cole-mehring/griffin/Griffin_kicad.kicad_pcb

## KiCad design Griffin_kicad.kicad_pcb (2026-10-20)

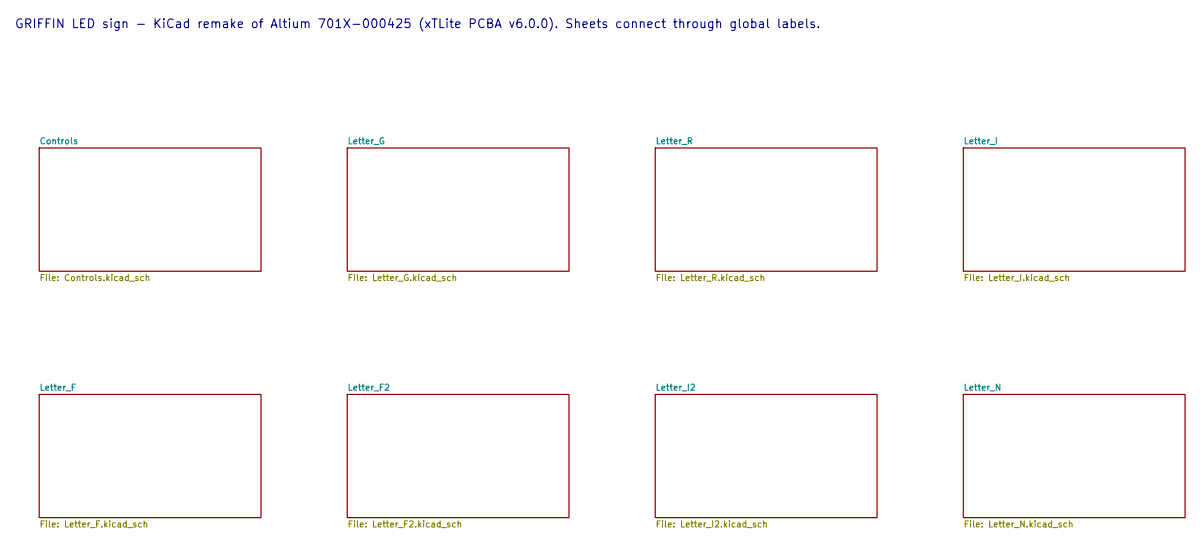
[picture p1: schematic Griffin_kicad.kicad_sch]

Notes on the sheet:
GRIFFIN LED sign - KiCad remake of Altium 701X-000425 (xTLite PCBA v6.0.0). Sheets connect through global labels.

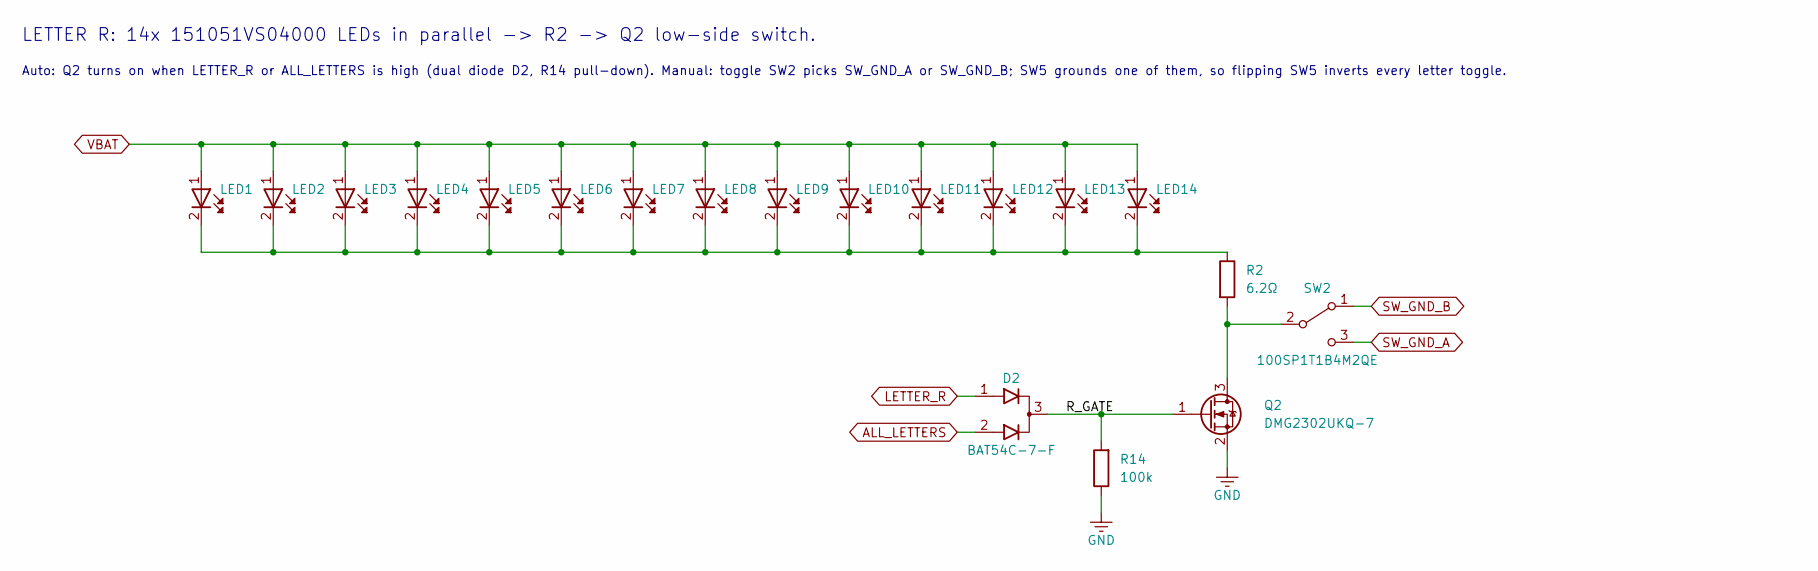
[picture p2: schematic Letter_R.kicad_sch]

Parts:
D2: BAT54C-7-F; SOT-23_Diodes; MPN BAT54C-7-F
LED1, LED2, LED3, LED4, LED5, LED6, LED7, LED8, LED9, LED10, LED11, LED12, LED13, LED14: 151051VS04000; LED_D5.0mm_WE-WL-TMRC_AnodePin1; MPN 151051VS04000
Q2: DMG2302UKQ-7; SOT-23_Diodes; MPN DMG2302UKQ-7
R2: 6.2Ω; R_1206_3216Metric; MPN RC1206FR-076R2L
R14: 100k; R_0805_2012Metric; MPN RC0805FR-07100KL
SW2: 100SP1T1B4M2QE; SW_Toggle_E-Switch_100SP_M2_P4.70mm; MPN 100SP1T1B4M2QE

Connections:
/Letter_R/R_GATE: D2.3 (K), Q2.1 (G), R14.2
ALL_LETTERS: D2.2 (A2); also elsewhere on the board
GND: Q2.2 (S), R14.1; also elsewhere on the board
LETTER_R: D2.1 (A1); also elsewhere on the board
unnamed: LED1.2 (K), LED2.2 (K), LED3.2 (K), LED4.2 (K), LED5.2 (K), LED6.2 (K), LED7.2 (K), LED8.2 (K), LED9.2 (K), LED10.2 (K), LED11.2 (K), LED12.2 (K), LED13.2 (K), LED14.2 (K), R2.1
unnamed: Q2.3 (D), R2.2, SW2.2 (C)
SW_GND_A: SW2.3 (B); also elsewhere on the board
SW_GND_B: SW2.1 (A); also elsewhere on the board
VBAT: LED1.1 (A), LED2.1 (A), LED3.1 (A), LED4.1 (A), LED5.1 (A), LED6.1 (A), LED7.1 (A), LED8.1 (A), LED9.1 (A), LED10.1 (A), LED11.1 (A), LED12.1 (A), LED13.1 (A), LED14.1 (A); also elsewhere on the board

Notes on the sheet:
Auto: Q2 turns on when LETTER_R or ALL_LETTERS is high (dual diode D2, R14 pull-down). Manual: toggle SW2 picks SW_GND_A or SW_GND_B; SW5 grounds one of them, so flipping SW5 inverts every letter toggle.
LETTER R: 14x 151051VS04000 LEDs in parallel -> R2 -> Q2 low-side switch.

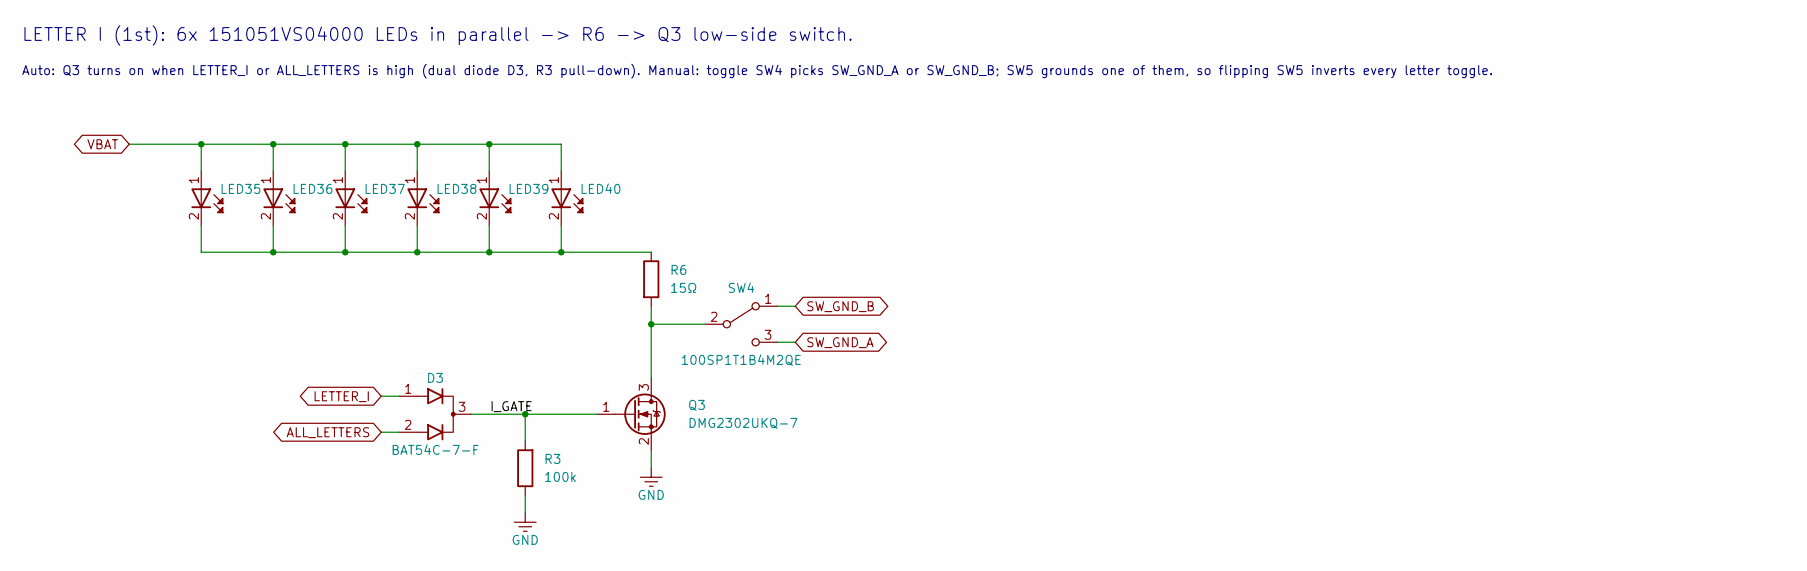
[picture p3: schematic Letter_I.kicad_sch]

Parts:
D3: BAT54C-7-F; SOT-23_Diodes; MPN BAT54C-7-F
LED35, LED36, LED37, LED38, LED39, LED40: 151051VS04000; LED_D5.0mm_WE-WL-TMRC_AnodePin1; MPN 151051VS04000
Q3: DMG2302UKQ-7; SOT-23_Diodes; MPN DMG2302UKQ-7
R3: 100k; R_0805_2012Metric; MPN RC0805FR-07100KL
R6: 15Ω; R_1206_3216Metric; MPN RC1206FR-0715RL
SW4: 100SP1T1B4M2QE; SW_Toggle_E-Switch_100SP_M2_P4.70mm; MPN 100SP1T1B4M2QE

Connections:
/Letter_I/I_GATE: D3.3 (K), Q3.1 (G), R3.2
ALL_LETTERS: D3.2 (A2); also elsewhere on the board
GND: Q3.2 (S), R3.1; also elsewhere on the board
LETTER_I: D3.1 (A1); also elsewhere on the board
unnamed: LED35.2 (K), LED36.2 (K), LED37.2 (K), LED38.2 (K), LED39.2 (K), LED40.2 (K), R6.1
unnamed: Q3.3 (D), R6.2, SW4.2 (C)
SW_GND_A: SW4.3 (B); also elsewhere on the board
SW_GND_B: SW4.1 (A); also elsewhere on the board
VBAT: LED35.1 (A), LED36.1 (A), LED37.1 (A), LED38.1 (A), LED39.1 (A), LED40.1 (A); also elsewhere on the board

Notes on the sheet:
Auto: Q3 turns on when LETTER_I or ALL_LETTERS is high (dual diode D3, R3 pull-down). Manual: toggle SW4 picks SW_GND_A or SW_GND_B; SW5 grounds one of them, so flipping SW5 inverts every letter toggle.
LETTER I (1st): 6x 151051VS04000 LEDs in parallel -> R6 -> Q3 low-side switch.

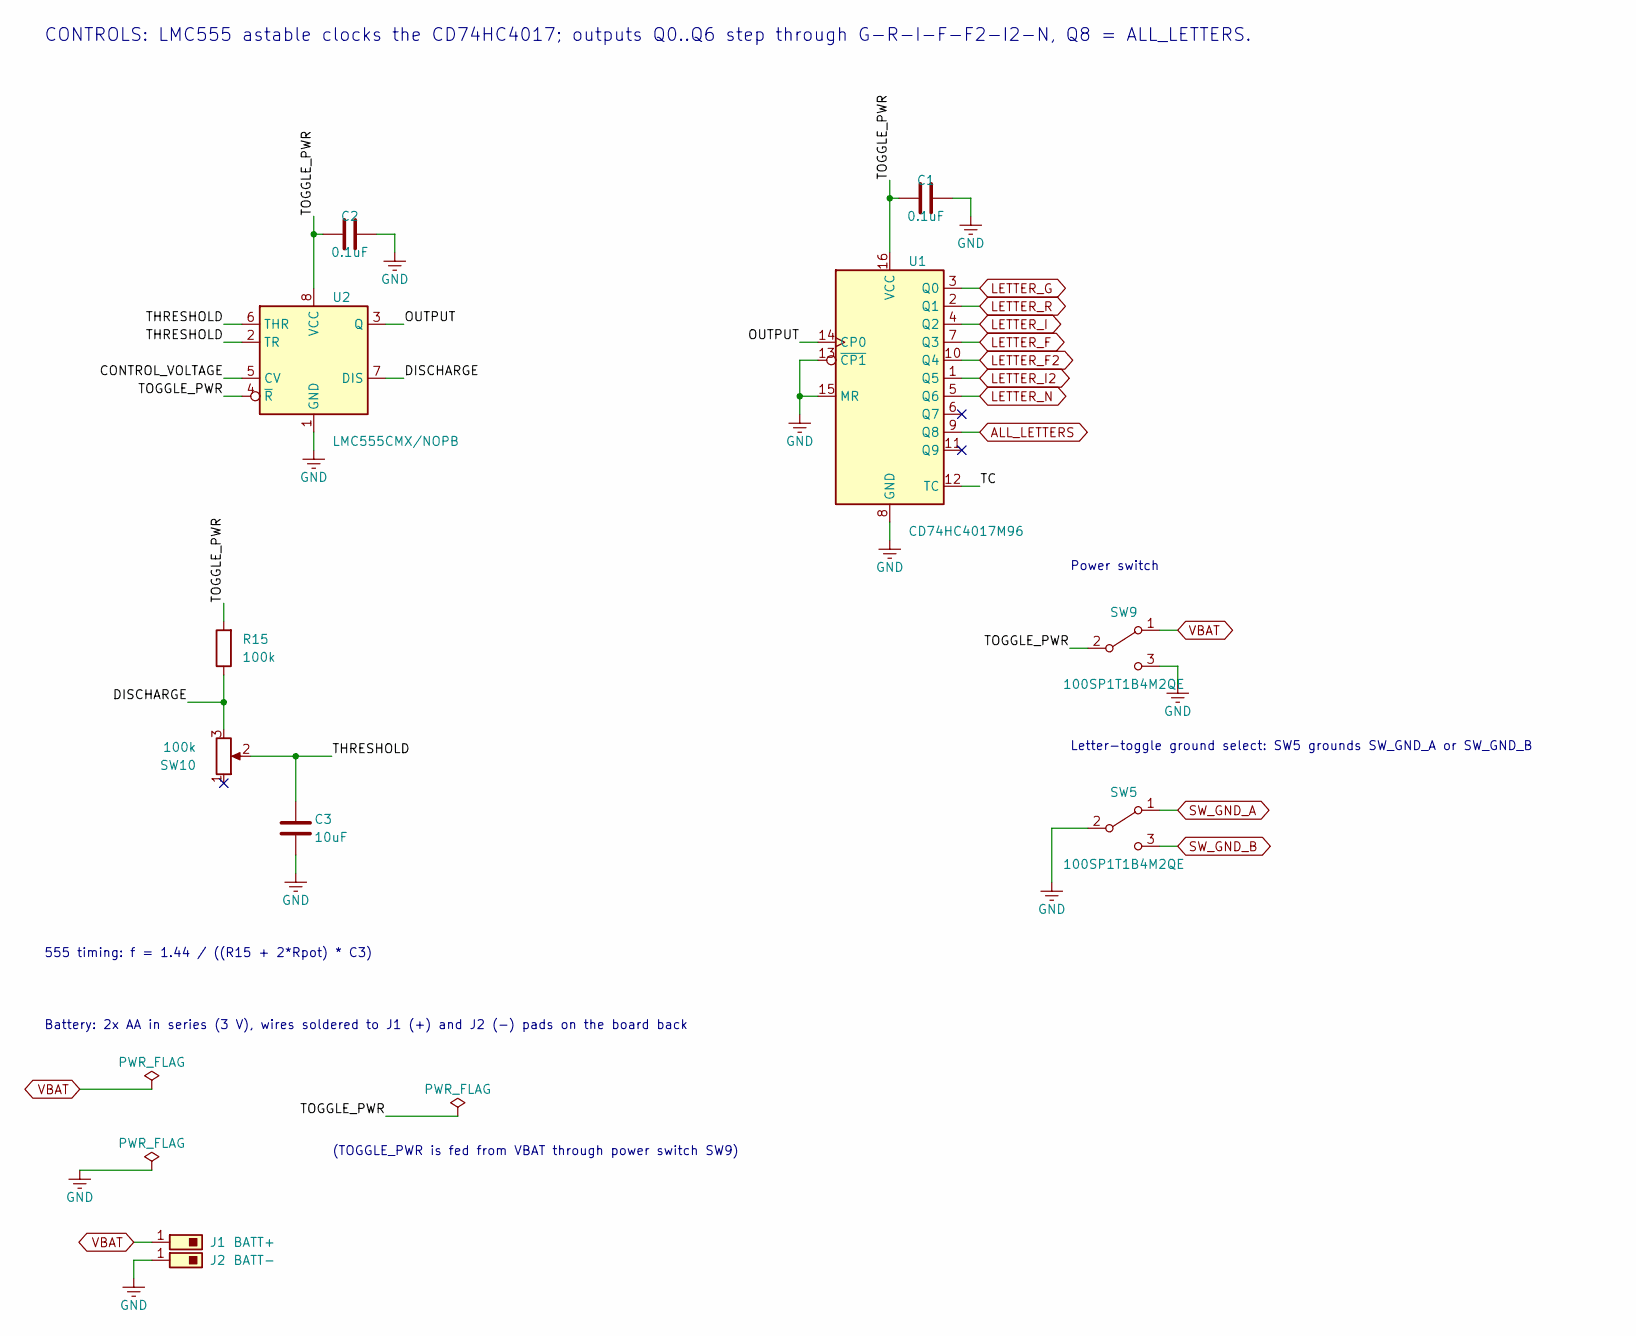
[picture p4: schematic Controls.kicad_sch]

Parts:
C1, C2: 0.1uF; C_0805_2012Metric; MPN CC0805KRX7R9BB104
C3: 10uF; C_0805_2012Metric; MPN GRM21BR61E106KA73L
J1: BATT+; SolderPad_1x1_8x8mm
J2: BATT-; SolderPad_1x1_8x8mm
R15: 100k; R_0805_2012Metric; MPN RC0805FR-07100KL
SW5, SW9: 100SP1T1B4M2QE; SW_Toggle_E-Switch_100SP_M2_P4.70mm; MPN 100SP1T1B4M2QE
SW10: 100k; Potentiometer_Bourns_PTV09A-4_Single_Vertical; MPN PTV09A-4025F-B104
U1: CD74HC4017M96; SOIC-16_3.9x9.9mm_P1.27mm; MPN CD74HC4017M96
U2: LMC555CMX/NOPB; SOIC-8_3.9x4.9mm_P1.27mm; MPN LMC555CMX/NOPB

Connections:
/Controls/CONTROL_VOLTAGE: U2.5 (CV)
/Controls/DISCHARGE: R15.1, SW10.3, U2.7 (DIS)
/Controls/OUTPUT: U1.14 (CP0), U2.3 (Q)
/Controls/TC: U1.12 (TC)
/Controls/THRESHOLD: C3.1, SW10.2, U2.2 (TR), U2.6 (THR)
/Controls/TOGGLE_PWR: C1.1, C2.1, R15.2, SW9.2 (C), U1.16 (VCC), U2.4 (~R), U2.8 (VCC)
ALL_LETTERS: U1.9 (Q8); also elsewhere on the board
GND: C1.2, C2.2, C3.2, J2.1 (~_1), SW5.2 (C), SW9.3 (B), U1.8 (GND), U1.13 (~CP1), U1.15 (MR), U2.1 (GND); also elsewhere on the board
LETTER_F: U1.7 (Q3); also elsewhere on the board
LETTER_F2: U1.10 (Q4); also elsewhere on the board
LETTER_G: U1.3 (Q0); also elsewhere on the board
LETTER_I: U1.4 (Q2); also elsewhere on the board
LETTER_I2: U1.1 (Q5); also elsewhere on the board
LETTER_N: U1.5 (Q6); also elsewhere on the board
LETTER_R: U1.2 (Q1); also elsewhere on the board
SW_GND_A: SW5.1 (A); also elsewhere on the board
SW_GND_B: SW5.3 (B); also elsewhere on the board
VBAT: J1.1 (~_1), SW9.1 (A); also elsewhere on the board

Notes on the sheet:
(TOGGLE_PWR is fed from VBAT through power switch SW9)
Battery: 2x AA in series (3 V), wires soldered to J1 (+) and J2 (-) pads on the board back
Letter-toggle ground select: SW5 grounds SW_GND_A or SW_GND_B
555 timing: f = 1.44 / ((R15 + 2*Rpot) * C3)
CONTROLS: LMC555 astable clocks the CD74HC4017; outputs Q0..Q6 step through G-R-I-F-F2-I2-N, Q8 = ALL_LETTERS.
Power switch

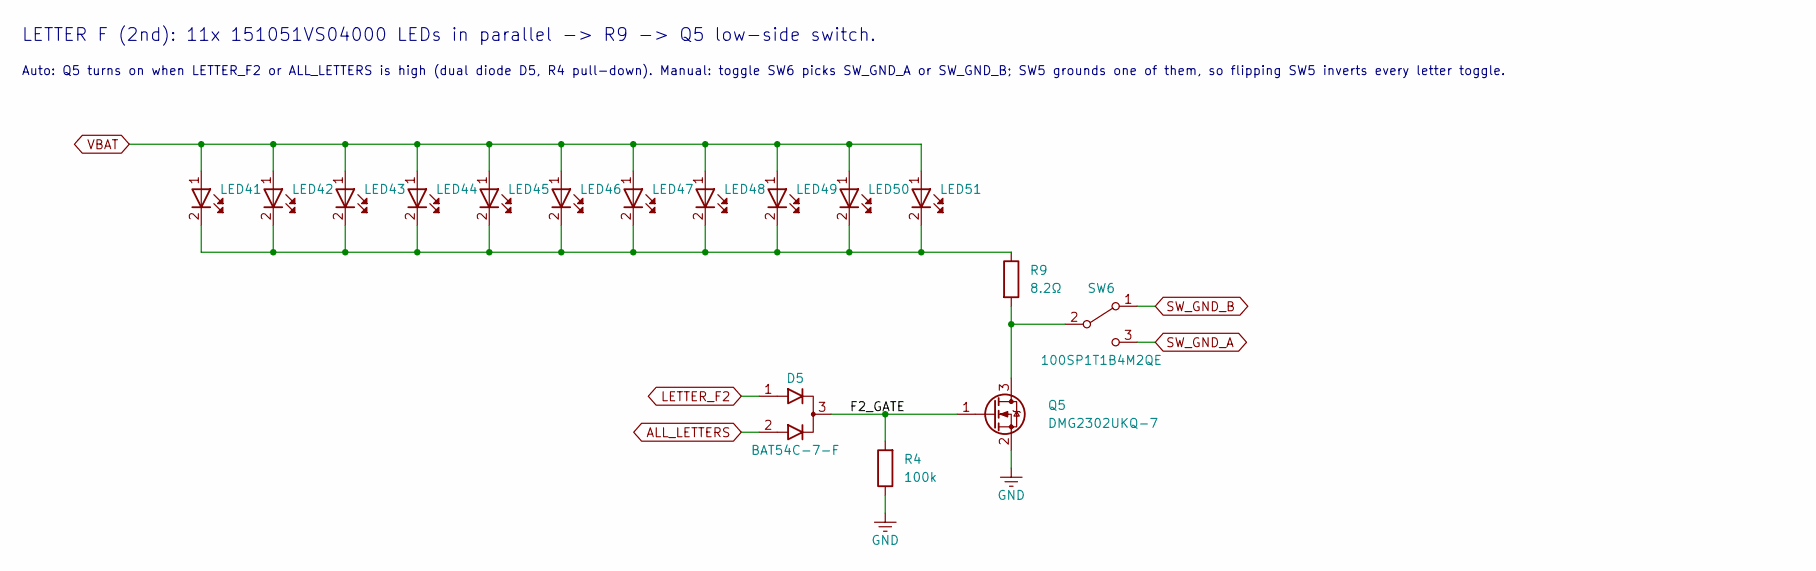
[picture p5: schematic Letter_F2.kicad_sch]

Parts:
D5: BAT54C-7-F; SOT-23_Diodes; MPN BAT54C-7-F
LED41, LED42, LED43, LED44, LED45, LED46, LED47, LED48, LED49, LED50, LED51: 151051VS04000; LED_D5.0mm_WE-WL-TMRC_AnodePin1; MPN 151051VS04000
Q5: DMG2302UKQ-7; SOT-23_Diodes; MPN DMG2302UKQ-7
R4: 100k; R_0805_2012Metric; MPN RC0805FR-07100KL
R9: 8.2Ω; R_1206_3216Metric; MPN RC1206FR-078R2L
SW6: 100SP1T1B4M2QE; SW_Toggle_E-Switch_100SP_M2_P4.70mm; MPN 100SP1T1B4M2QE

Connections:
/Letter_F2/F2_GATE: D5.3 (K), Q5.1 (G), R4.2
ALL_LETTERS: D5.2 (A2); also elsewhere on the board
GND: Q5.2 (S), R4.1; also elsewhere on the board
LETTER_F2: D5.1 (A1); also elsewhere on the board
unnamed: LED41.2 (K), LED42.2 (K), LED43.2 (K), LED44.2 (K), LED45.2 (K), LED46.2 (K), LED47.2 (K), LED48.2 (K), LED49.2 (K), LED50.2 (K), LED51.2 (K), R9.1
unnamed: Q5.3 (D), R9.2, SW6.2 (C)
SW_GND_A: SW6.3 (B); also elsewhere on the board
SW_GND_B: SW6.1 (A); also elsewhere on the board
VBAT: LED41.1 (A), LED42.1 (A), LED43.1 (A), LED44.1 (A), LED45.1 (A), LED46.1 (A), LED47.1 (A), LED48.1 (A), LED49.1 (A), LED50.1 (A), LED51.1 (A); also elsewhere on the board

Notes on the sheet:
Auto: Q5 turns on when LETTER_F2 or ALL_LETTERS is high (dual diode D5, R4 pull-down). Manual: toggle SW6 picks SW_GND_A or SW_GND_B; SW5 grounds one of them, so flipping SW5 inverts every letter toggle.
LETTER F (2nd): 11x 151051VS04000 LEDs in parallel -> R9 -> Q5 low-side switch.

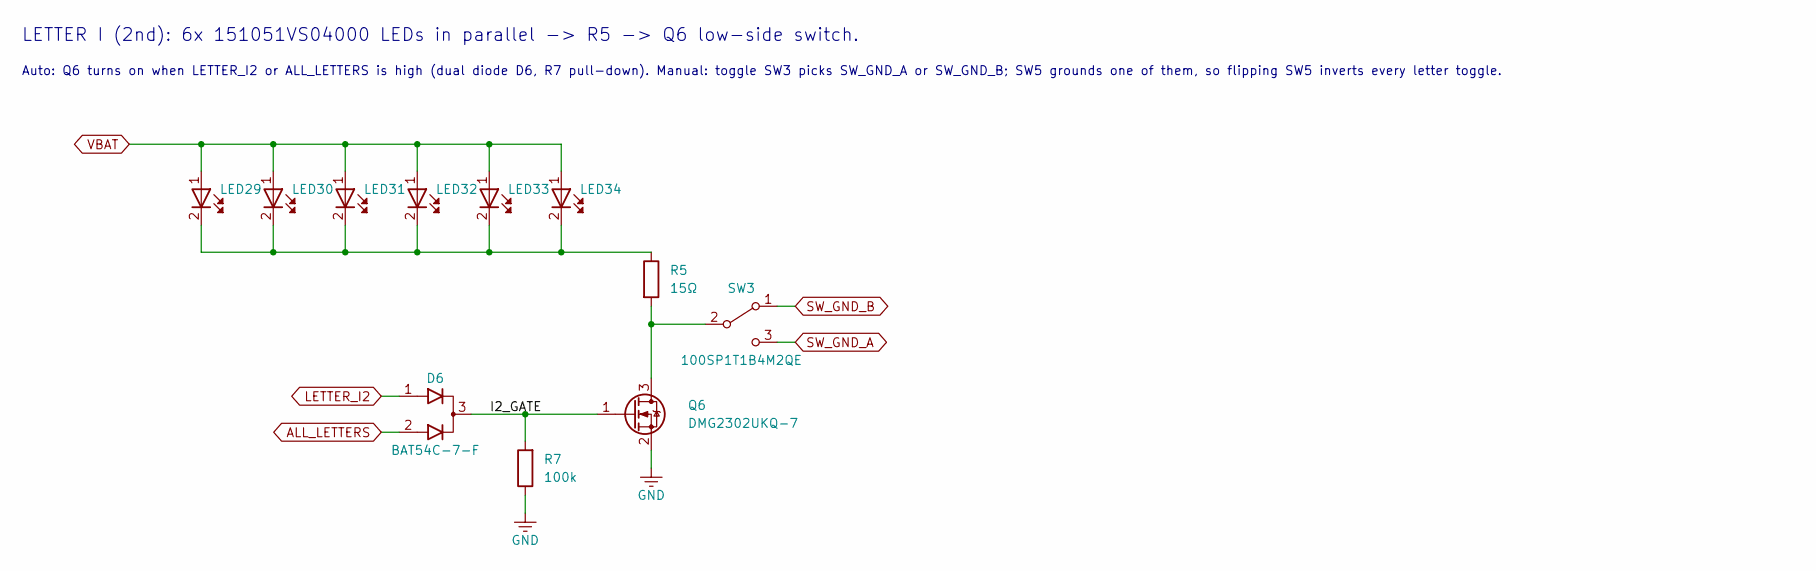
[picture p6: schematic Letter_I2.kicad_sch]

Parts:
D6: BAT54C-7-F; SOT-23_Diodes; MPN BAT54C-7-F
LED29, LED30, LED31, LED32, LED33, LED34: 151051VS04000; LED_D5.0mm_WE-WL-TMRC_AnodePin1; MPN 151051VS04000
Q6: DMG2302UKQ-7; SOT-23_Diodes; MPN DMG2302UKQ-7
R5: 15Ω; R_1206_3216Metric; MPN RC1206FR-0715RL
R7: 100k; R_0805_2012Metric; MPN RC0805FR-07100KL
SW3: 100SP1T1B4M2QE; SW_Toggle_E-Switch_100SP_M2_P4.70mm; MPN 100SP1T1B4M2QE

Connections:
/Letter_I2/I2_GATE: D6.3 (K), Q6.1 (G), R7.2
ALL_LETTERS: D6.2 (A2); also elsewhere on the board
GND: Q6.2 (S), R7.1; also elsewhere on the board
LETTER_I2: D6.1 (A1); also elsewhere on the board
unnamed: LED29.2 (K), LED30.2 (K), LED31.2 (K), LED32.2 (K), LED33.2 (K), LED34.2 (K), R5.1
unnamed: Q6.3 (D), R5.2, SW3.2 (C)
SW_GND_A: SW3.3 (B); also elsewhere on the board
SW_GND_B: SW3.1 (A); also elsewhere on the board
VBAT: LED29.1 (A), LED30.1 (A), LED31.1 (A), LED32.1 (A), LED33.1 (A), LED34.1 (A); also elsewhere on the board

Notes on the sheet:
LETTER I (2nd): 6x 151051VS04000 LEDs in parallel -> R5 -> Q6 low-side switch.
Auto: Q6 turns on when LETTER_I2 or ALL_LETTERS is high (dual diode D6, R7 pull-down). Manual: toggle SW3 picks SW_GND_A or SW_GND_B; SW5 grounds one of them, so flipping SW5 inverts every letter toggle.

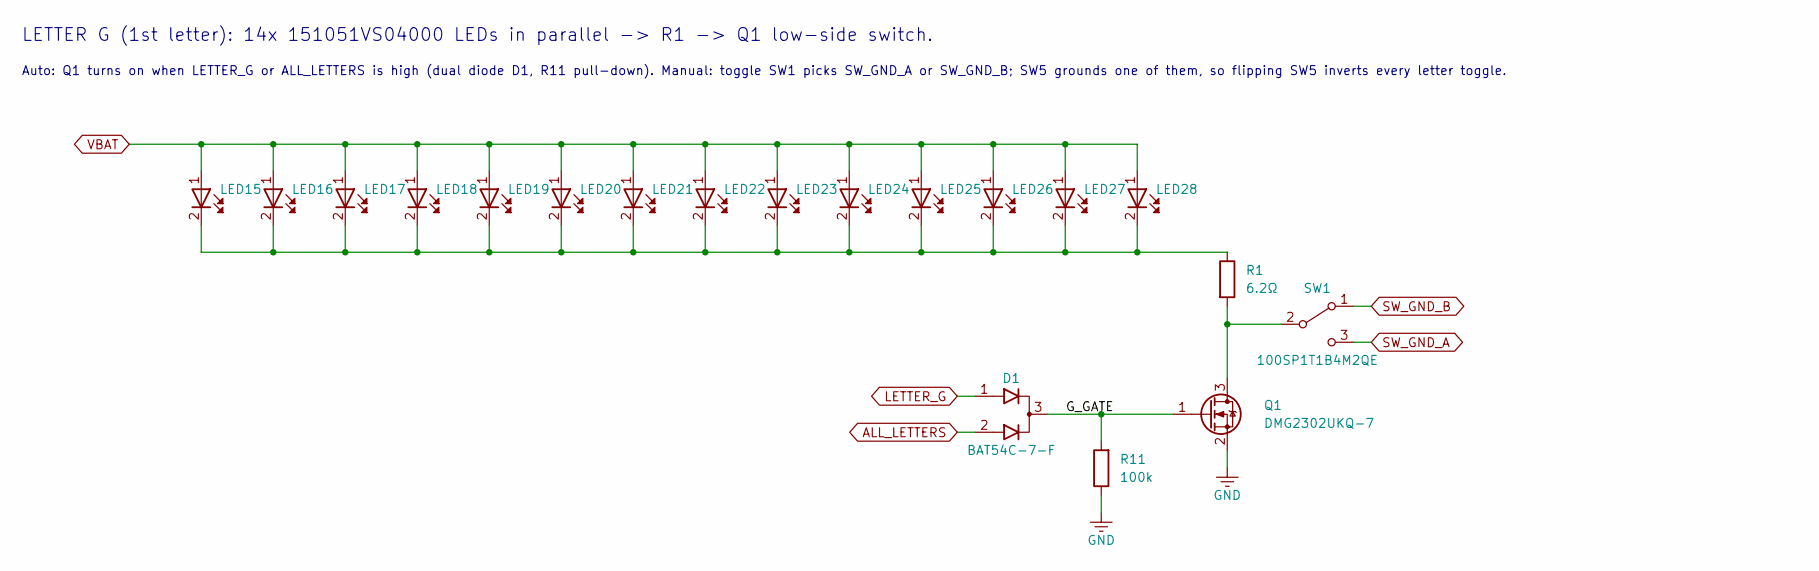
[picture p7: schematic Letter_G.kicad_sch]

Parts:
D1: BAT54C-7-F; SOT-23_Diodes; MPN BAT54C-7-F
LED15, LED16, LED17, LED18, LED19, LED20, LED21, LED22, LED23, LED24, LED25, LED26, LED27, LED28: 151051VS04000; LED_D5.0mm_WE-WL-TMRC_AnodePin1; MPN 151051VS04000
Q1: DMG2302UKQ-7; SOT-23_Diodes; MPN DMG2302UKQ-7
R1: 6.2Ω; R_1206_3216Metric; MPN RC1206FR-076R2L
R11: 100k; R_0805_2012Metric; MPN RC0805FR-07100KL
SW1: 100SP1T1B4M2QE; SW_Toggle_E-Switch_100SP_M2_P4.70mm; MPN 100SP1T1B4M2QE

Connections:
/Letter_G/G_GATE: D1.3 (K), Q1.1 (G), R11.2
ALL_LETTERS: D1.2 (A2); also elsewhere on the board
GND: Q1.2 (S), R11.1; also elsewhere on the board
LETTER_G: D1.1 (A1); also elsewhere on the board
unnamed: LED15.2 (K), LED16.2 (K), LED17.2 (K), LED18.2 (K), LED19.2 (K), LED20.2 (K), LED21.2 (K), LED22.2 (K), LED23.2 (K), LED24.2 (K), LED25.2 (K), LED26.2 (K), LED27.2 (K), LED28.2 (K), R1.1
unnamed: Q1.3 (D), R1.2, SW1.2 (C)
SW_GND_A: SW1.3 (B); also elsewhere on the board
SW_GND_B: SW1.1 (A); also elsewhere on the board
VBAT: LED15.1 (A), LED16.1 (A), LED17.1 (A), LED18.1 (A), LED19.1 (A), LED20.1 (A), LED21.1 (A), LED22.1 (A), LED23.1 (A), LED24.1 (A), LED25.1 (A), LED26.1 (A), LED27.1 (A), LED28.1 (A); also elsewhere on the board

Notes on the sheet:
Auto: Q1 turns on when LETTER_G or ALL_LETTERS is high (dual diode D1, R11 pull-down). Manual: toggle SW1 picks SW_GND_A or SW_GND_B; SW5 grounds one of them, so flipping SW5 inverts every letter toggle.
LETTER G (1st letter): 14x 151051VS04000 LEDs in parallel -> R1 -> Q1 low-side switch.

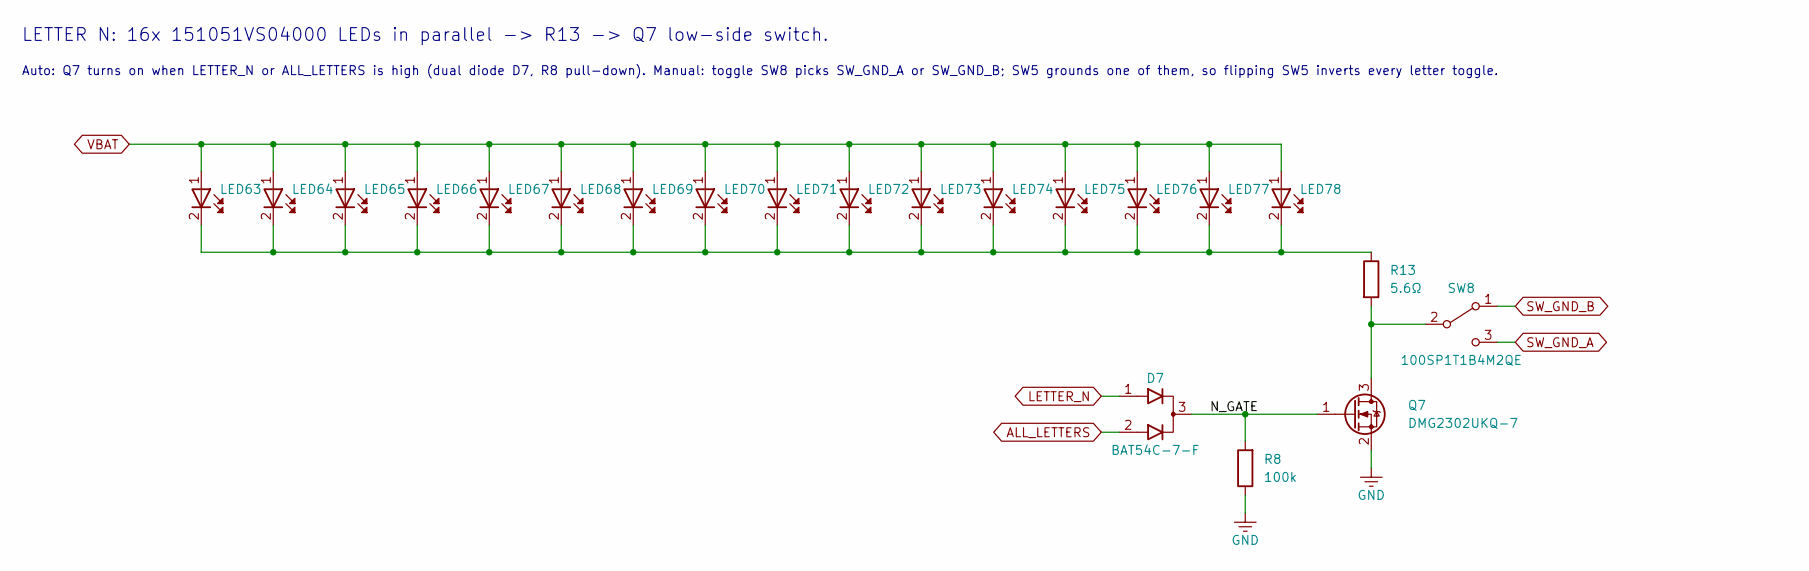
[picture p8: schematic Letter_N.kicad_sch]

Parts:
D7: BAT54C-7-F; SOT-23_Diodes; MPN BAT54C-7-F
LED63, LED64, LED65, LED66, LED67, LED68, LED69, LED70, LED71, LED72, LED73, LED74, LED75, LED76, LED77, LED78: 151051VS04000; LED_D5.0mm_WE-WL-TMRC_AnodePin1; MPN 151051VS04000
Q7: DMG2302UKQ-7; SOT-23_Diodes; MPN DMG2302UKQ-7
R8: 100k; R_0805_2012Metric; MPN RC0805FR-07100KL
R13: 5.6Ω; R_1206_3216Metric; MPN RC1206FR-075R6L
SW8: 100SP1T1B4M2QE; SW_Toggle_E-Switch_100SP_M2_P4.70mm; MPN 100SP1T1B4M2QE

Connections:
/Letter_N/N_GATE: D7.3 (K), Q7.1 (G), R8.2
ALL_LETTERS: D7.2 (A2); also elsewhere on the board
GND: Q7.2 (S), R8.1; also elsewhere on the board
LETTER_N: D7.1 (A1); also elsewhere on the board
unnamed: LED63.2 (K), LED64.2 (K), LED65.2 (K), LED66.2 (K), LED67.2 (K), LED68.2 (K), LED69.2 (K), LED70.2 (K), LED71.2 (K), LED72.2 (K), LED73.2 (K), LED74.2 (K), LED75.2 (K), LED76.2 (K), LED77.2 (K), LED78.2 (K), R13.1
unnamed: Q7.3 (D), R13.2, SW8.2 (C)
SW_GND_A: SW8.3 (B); also elsewhere on the board
SW_GND_B: SW8.1 (A); also elsewhere on the board
VBAT: LED63.1 (A), LED64.1 (A), LED65.1 (A), LED66.1 (A), LED67.1 (A), LED68.1 (A), LED69.1 (A), LED70.1 (A), LED71.1 (A), LED72.1 (A), LED73.1 (A), LED74.1 (A), LED75.1 (A), LED76.1 (A), LED77.1 (A), LED78.1 (A); also elsewhere on the board

Notes on the sheet:
LETTER N: 16x 151051VS04000 LEDs in parallel -> R13 -> Q7 low-side switch.
Auto: Q7 turns on when LETTER_N or ALL_LETTERS is high (dual diode D7, R8 pull-down). Manual: toggle SW8 picks SW_GND_A or SW_GND_B; SW5 grounds one of them, so flipping SW5 inverts every letter toggle.

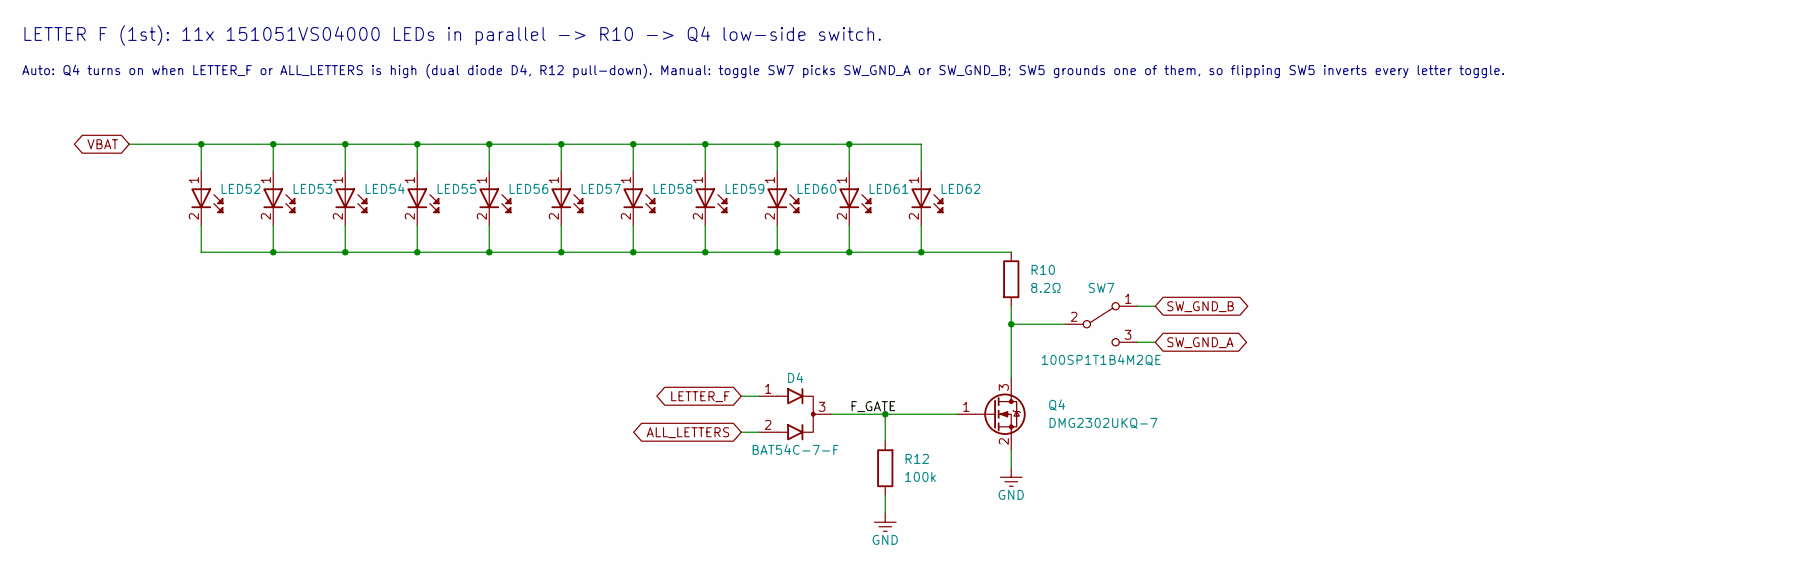
[picture p9: schematic Letter_F.kicad_sch]

Parts:
D4: BAT54C-7-F; SOT-23_Diodes; MPN BAT54C-7-F
LED52, LED53, LED54, LED55, LED56, LED57, LED58, LED59, LED60, LED61, LED62: 151051VS04000; LED_D5.0mm_WE-WL-TMRC_AnodePin1; MPN 151051VS04000
Q4: DMG2302UKQ-7; SOT-23_Diodes; MPN DMG2302UKQ-7
R10: 8.2Ω; R_1206_3216Metric; MPN RC1206FR-078R2L
R12: 100k; R_0805_2012Metric; MPN RC0805FR-07100KL
SW7: 100SP1T1B4M2QE; SW_Toggle_E-Switch_100SP_M2_P4.70mm; MPN 100SP1T1B4M2QE

Connections:
/Letter_F/F_GATE: D4.3 (K), Q4.1 (G), R12.2
ALL_LETTERS: D4.2 (A2); also elsewhere on the board
GND: Q4.2 (S), R12.1; also elsewhere on the board
LETTER_F: D4.1 (A1); also elsewhere on the board
unnamed: LED52.2 (K), LED53.2 (K), LED54.2 (K), LED55.2 (K), LED56.2 (K), LED57.2 (K), LED58.2 (K), LED59.2 (K), LED60.2 (K), LED61.2 (K), LED62.2 (K), R10.1
unnamed: Q4.3 (D), R10.2, SW7.2 (C)
SW_GND_A: SW7.3 (B); also elsewhere on the board
SW_GND_B: SW7.1 (A); also elsewhere on the board
VBAT: LED52.1 (A), LED53.1 (A), LED54.1 (A), LED55.1 (A), LED56.1 (A), LED57.1 (A), LED58.1 (A), LED59.1 (A), LED60.1 (A), LED61.1 (A), LED62.1 (A); also elsewhere on the board

Notes on the sheet:
LETTER F (1st): 11x 151051VS04000 LEDs in parallel -> R10 -> Q4 low-side switch.
Auto: Q4 turns on when LETTER_F or ALL_LETTERS is high (dual diode D4, R12 pull-down). Manual: toggle SW7 picks SW_GND_A or SW_GND_B; SW5 grounds one of them, so flipping SW5 inverts every letter toggle.

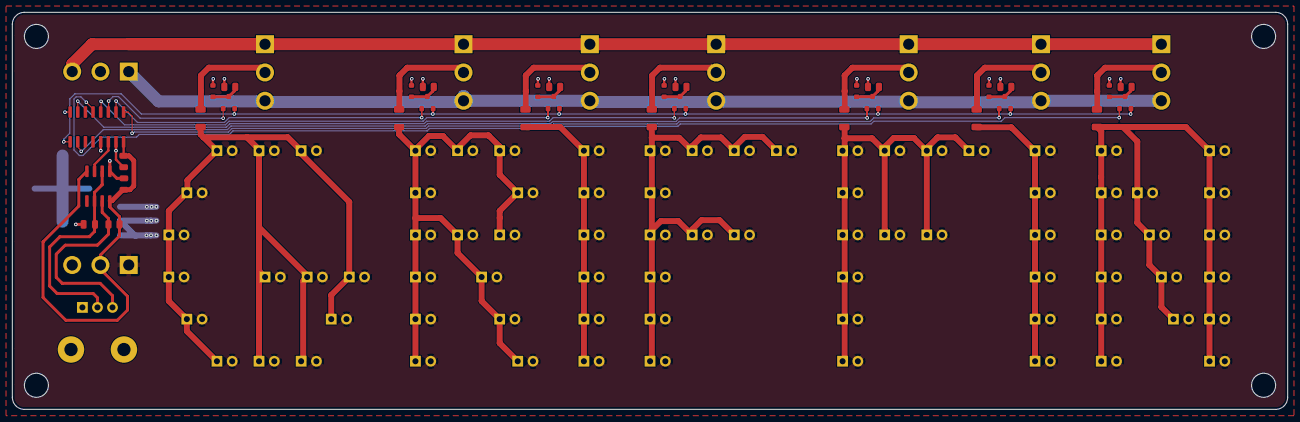
[picture p10: board Griffin_kicad.kicad_pcb from above]

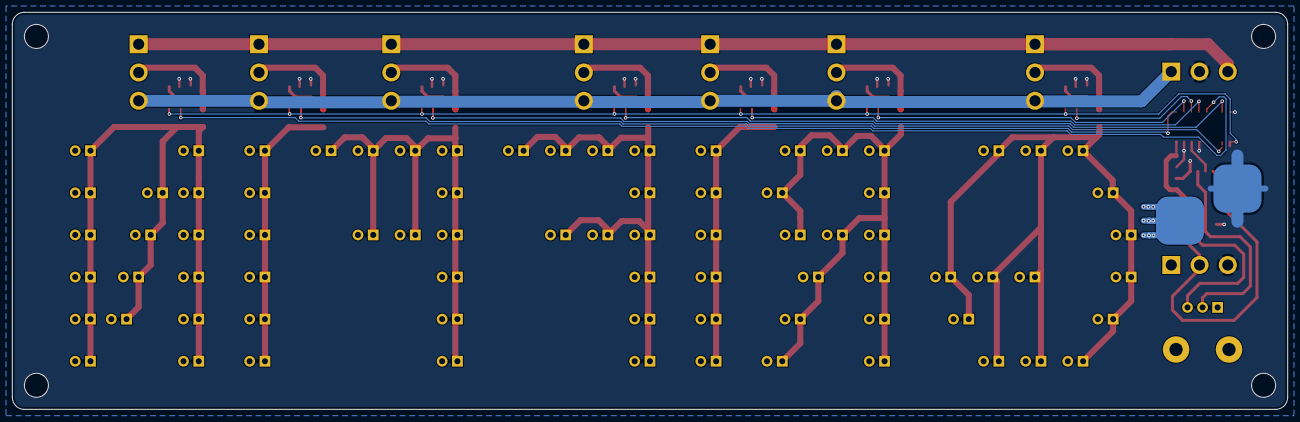
[picture p11: board Griffin_kicad.kicad_pcb from below]

Board: 2 copper layers, 212.0 x 66.0 mm, 128 parts (2 on the bottom side), 37 nets.

Other parts of the board:
H1, H2, H3, H4: MountingHole_4.0mm; MountingHole_4.0mm_NPTH
