cole-mehring/griffin/(commit log)

2026-10-17 Add in initial files
    [Controls.kicad_sch, Griffin_kicad.kicad_pcb, Griffin_kicad.kicad_sch, Letter_F.kicad_sch, Letter_F2.kicad_sch, Letter_G.kicad_sch, Letter_I.kicad_sch, Letter_I2.kicad_sch]
2026-10-18 Add in changes: move to 0805 parts, routing updates
    [Controls.kicad_sch, Griffin_kicad.kicad_pcb, Letter_F.kicad_sch, Letter_F2.kicad_sch, Letter_G.kicad_sch, Letter_I.kicad_sch, Letter_I2.kicad_sch, Letter_N.kicad_sch]
2026-10-19 Add in final updates
    [Controls.kicad_sch, Griffin_kicad.kicad_pcb, Griffin_kicad.kicad_sch, Letter_F.kicad_sch, Letter_F2.kicad_sch, Letter_G.kicad_sch, Letter_I.kicad_sch, Letter_I2.kicad_sch]
2026-10-20 Add in griffin board update, this one is ordered!
    [Griffin_kicad.kicad_pcb]
